Boardoza/Boardoza_STM32F411_Black_Pill_Development_Board/assets/STM32F411CEU6_Blackpill.pdf

Boardoza STM32F411CEU6 (Black Pill) Pinouts

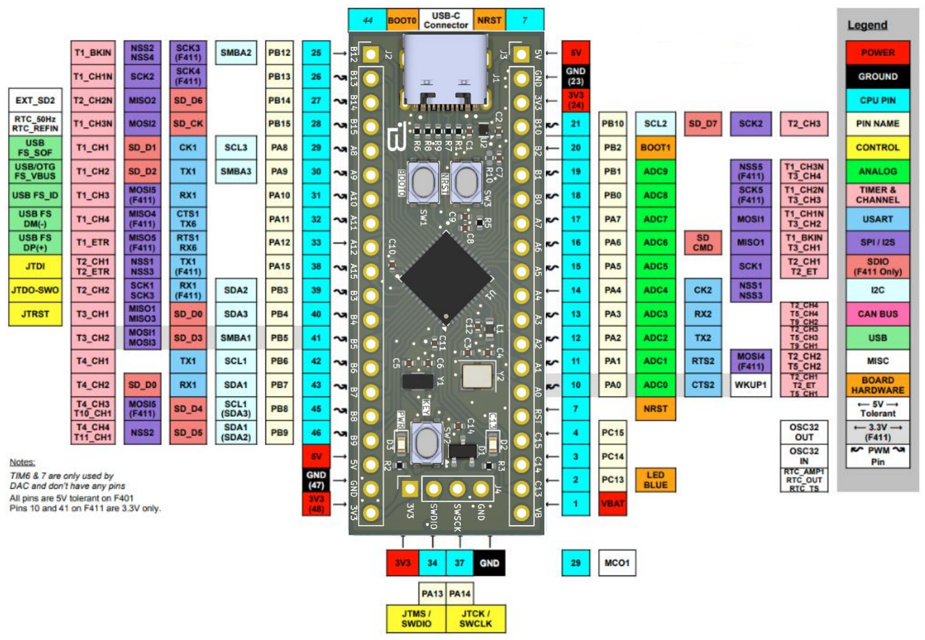
[picture p4: figure]
