Boardoza/Boardoza_STM32F411_Black_Pill_Development_Board/assets/STM32F411CEU6 Step.step

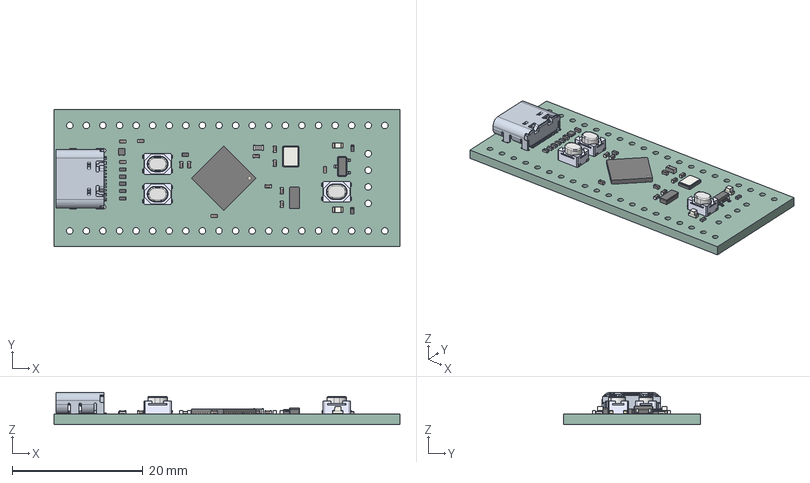
[picture p5: CAD file, 2026-08-12]
assets/STM32F411CEU6 Step.step
53.0 x 21.0 x 4.96 mm
LED_0603_1608Metric x 2
PTS810SJS250SMTR LFS x 3
C_0402_1005Metric x 13
Crystal_SMD_3225-4Pin_3.2x2.5mm
L_0603_1608Metric
USB4105GFA120
R_0402_1005Metric x 8
SOT_23
QFN-48-1EP_7x7mm_Pitch0.5mm
MicroCrystal_CC7V_T1A
_autosave-B-STM32F411-EVAL_PCB
