Boardoza/Boardoza_STM32F411_Black_Pill_Development_Board/hardware files/B-STM32F411-EVAL-R1.0.kicad_pcb

## KiCad design hardware files/B-STM32F411-EVAL-R1.0.kicad_pcb (2026-08-12)

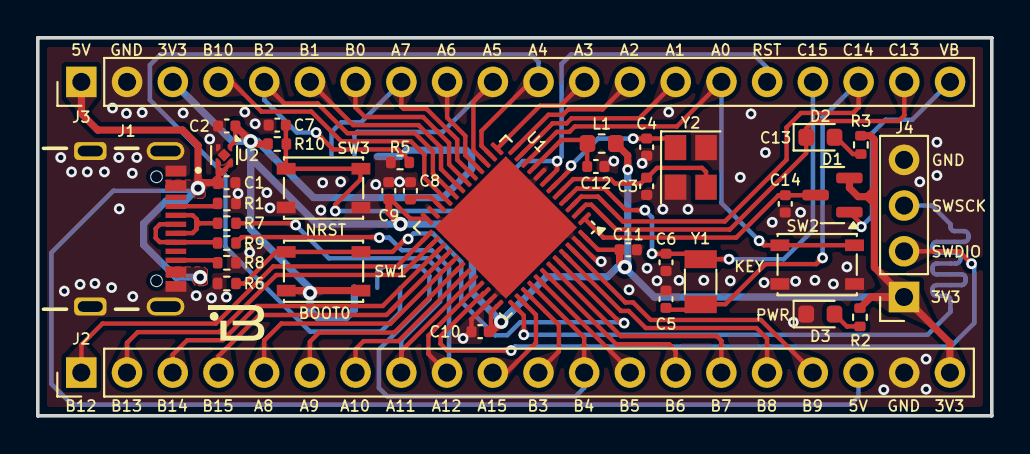
[picture p6: board B-STM32F411-EVAL-R1.0.kicad_pcb from above]

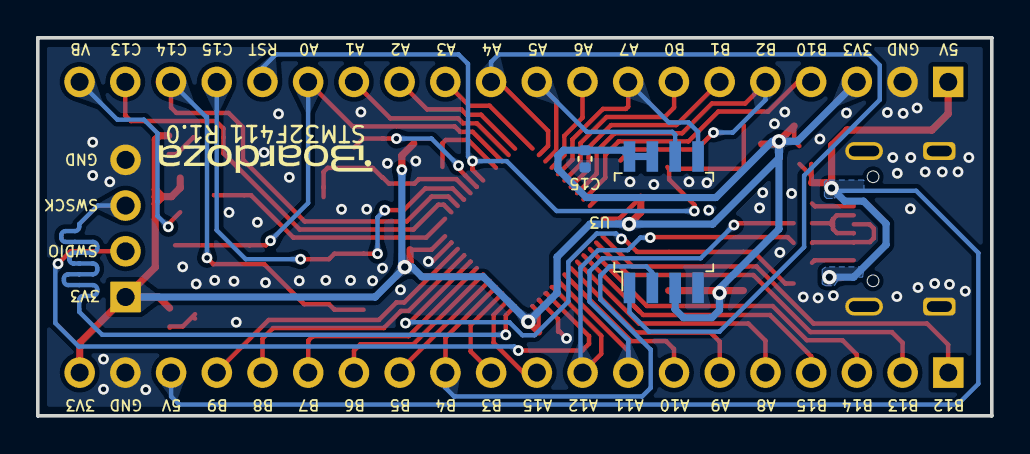
[picture p7: board B-STM32F411-EVAL-R1.0.kicad_pcb from below]

Board: 2 copper layers, 53.0 x 21.0 mm, 39 parts (2 on the bottom side), 51 nets.

Parts:
C1, C2: 1uF; C_0402_1005Metric
C3, C4: 10pF; C_0402_1005Metric
C5, C6: 12pF; C_0402_1005Metric
C7, C9, C10, C11, C12, C14, C15: 100nF; C_0402_1005Metric
C8: 2.2uF; C_0402_1005Metric
D1: BAT54C; SOT-23
D2, D3: LED; LED_0603_1608Metric
J1: USB_C_Receptacle_USB2.0_16P; GCT_USB4105GFA120
J2, J3: Conn_01x20; PinHeader_1x20_P2.54mm_Vertical
J4: Conn_01x04; PinSocket_1x04_P2.54mm_Vertical
L1: 10uH; L_0603_1608Metric
R1, R8: 5.1K; R_0402_1005Metric
R2, R3: 330R; R_0402_1005Metric
R5, R6, R10: 10K; R_0402_1005Metric
R7, R9: 10R; R_0402_1005Metric
SW1, SW2, SW3: SW_MEC_5E; SW_SPST_PTS810
U1: STM32F411CEU6; QFN-48-1EP_7x7mm_P0.5mm_EP5.6x5.6mm
U2: AP7343D-33FS4-7B; OnSemi_XDFN4-1EP_1.0x1.0mm_EP0.52x0.52mm
U3: W25Q32JVSSIQ-TR; SOIC-8_W5.6mm
Y1: 32.768kHz; Crystal_SMD_3215-2Pin_3.2x1.5mm
Y2: 25MHz; Crystal_SMD_3225-4Pin_3.2x2.5mm

Connections:
/BOOT0: R6.1, SW1.1, SW1.2, U1.44 (BOOT0)
/NRST: C7.1, J3.16, R10.2, SW3.1, SW3.2, U1.7 (NRST)
/PA0: J3.15, SW2.1, SW2.2, U1.10 (PA0)
/PA1: J3.14, U1.11 (PA1)
/PA2: J3.13, U1.12 (PA2)
/PA3: J3.12, U1.13 (PA3)
/PA4: J3.11, U1.14 (PA4), U3.1 (~CS)
/PA5: J3.10, U1.15 (PA5), U3.6 (CLK)
/PA6: J3.9, U1.16 (PA6)
/PA7: J3.8, U1.17 (PA7), U3.5 (DI)
/PA8: J2.5, U1.29 (PA8)
/PA9: J2.6, U1.30 (PA9)
/PA10: J2.7, U1.31 (PA10)
/PA11: J2.8, R7.2, U1.32 (PA11)
/PA12: J2.9, R9.2, U1.33 (PA12)
/PA13: J4.2, U1.34 (PA13)
/PA14: J4.3, U1.37 (PA14)
/PA15: J2.10, U1.38 (PA15)
/PB0: J3.7, U1.18 (PB0)
/PB1: J3.6, U1.19 (PB1)
/PB2: J3.5, R5.1, U1.20 (PB2)
/PB3: J2.11, U1.39 (PB3)
/PB4: J2.12, U1.40 (PB4), U3.2 (DO)
/PB5: J2.13, U1.41 (PB5)
/PB6: J2.14, U1.42 (PB6)
/PB7: J2.15, U1.43 (PB7)
/PB8: J2.16, U1.45 (PB8)
/PB9: J2.17, U1.46 (PB9)
/PB10: J3.4, U1.21 (PB10)
/PB12: J2.1, U1.25 (PB12)
/PB13: J2.2, U1.26 (PB13)
/PB14: J2.3, U1.27 (PB14)
/PB15: J2.4, U1.28 (PB15)
/PC13: D2.1 (K), J3.19, U1.2 (PC13)
/PC14: C5.1, J3.18, U1.3 (PC14), Y1.2
/PC15: C6.1, J3.17, U1.4 (PC15), Y1.1
/VB: D1.1, J3.20
/VBAT: C14.1, D1.3, U1.1 (VBAT)
/VBUS: C1.1, J1.A4_B9 (VBUS), J1.B4_A9 (VBUS), J2.18, J3.1, U2.3 (EN), U2.4 (IN)
/VDD: C2.1, C9.1, C10.1, C11.1, C15.1, D1.2, J2.20, J3.3, J4.1, L1.2, R2.1, R3.1, R10.1, SW1.3 (K), SW1.4 (A), U1.24 (VDD), U1.36 (VDD), U1.48 (VDD), U2.1 (OUT), U3.3 (~WP), U3.7 (~RST), U3.8 (VCC)
GND: C1.2, C2.2, C3.2, C4.2, C5.2, C6.2, C7.2, C8.2, C9.2, C10.2, C11.2, C12.2, C14.2, C15.2, D3.1 (K), J1.A1_B12 (GND), J1.B1_A12 (GND), J1.SH1 (SHIELD), J2.19, J3.2, J4.4, R1.2, R5.2, R6.2, R8.2, SW2.3 (K), SW2.4 (A), SW3.3 (K), SW3.4 (A), U1.8 (VSSA), U1.23 (VSS), U1.35 (VSS), U1.47 (VSS), U1.49 (VSS), U2.2 (GND), U2.5 (GND), U3.4 (GND), Y2.2, Y2.4
unnamed: D2.2 (A), R3.2
unnamed: D3.2 (A), R2.2
unnamed: J1.A5 (CC1), R1.1
unnamed: J1.B5 (CC2), R8.1
unnamed: J1.A6 (D+), J1.B6 (D+), R9.1
unnamed: J1.A7 (D-), J1.B7 (D-), R7.1
unnamed: C3.1, U1.5 (PH0), Y2.3
unnamed: C4.1, U1.6 (PH1), Y2.1
unnamed: C8.1, U1.22 (VCAP1)
unnamed: C12.1, L1.1, U1.9 (VDDA)
