Boardoza/Boardoza_STM32F411_Black_Pill_Development_Board/(notices)

Notices in the files:
README.md:
CC BY-SA 4.0
